hw-myry/esp32s3-4G-watch/04.fotos/solder1.jpg

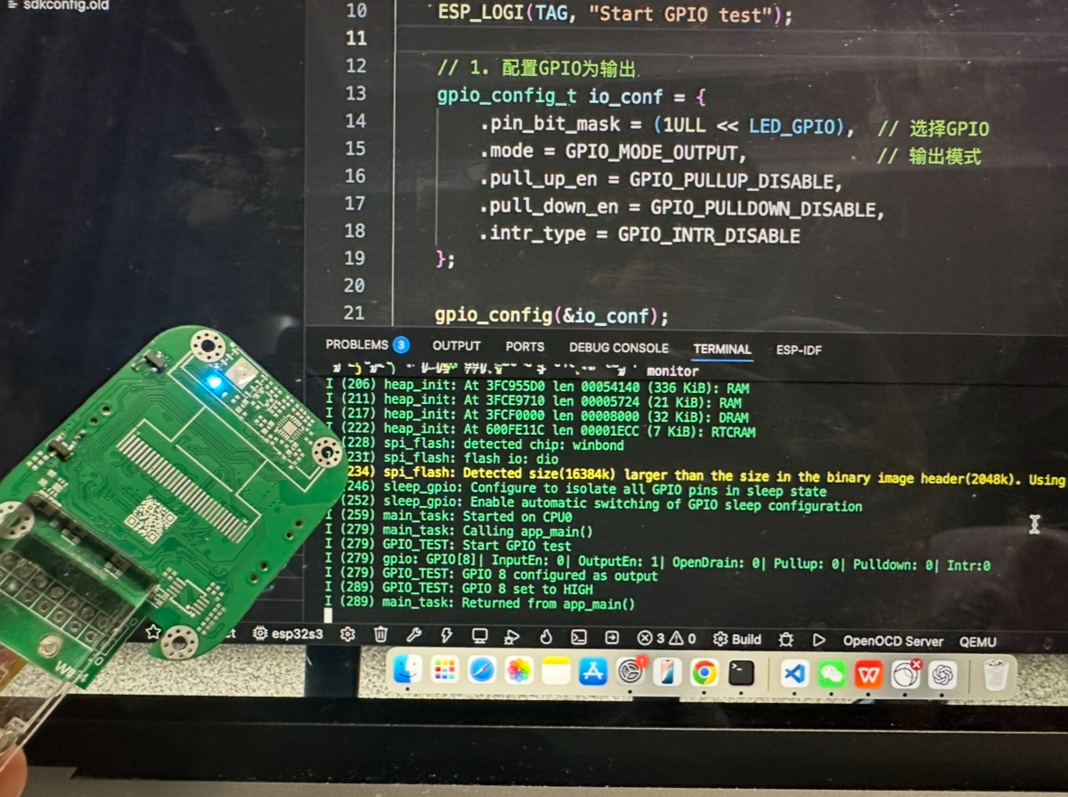
04.fotos/solder1.jpg
