hw-myry/esp32s3-4G-watch/04.fotos/solder2.jpg

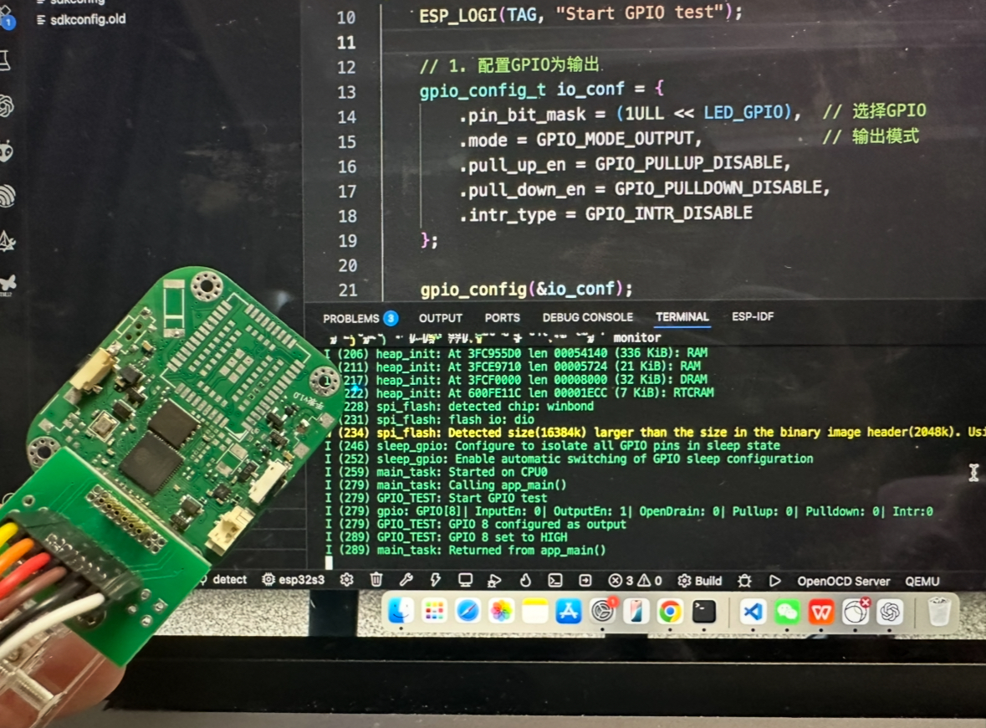
04.fotos/solder2.jpg
