hw-myry/esp32s3-4G-watch/01.hardware/4G-watch.pdf

# SGM6036

# PWR EN

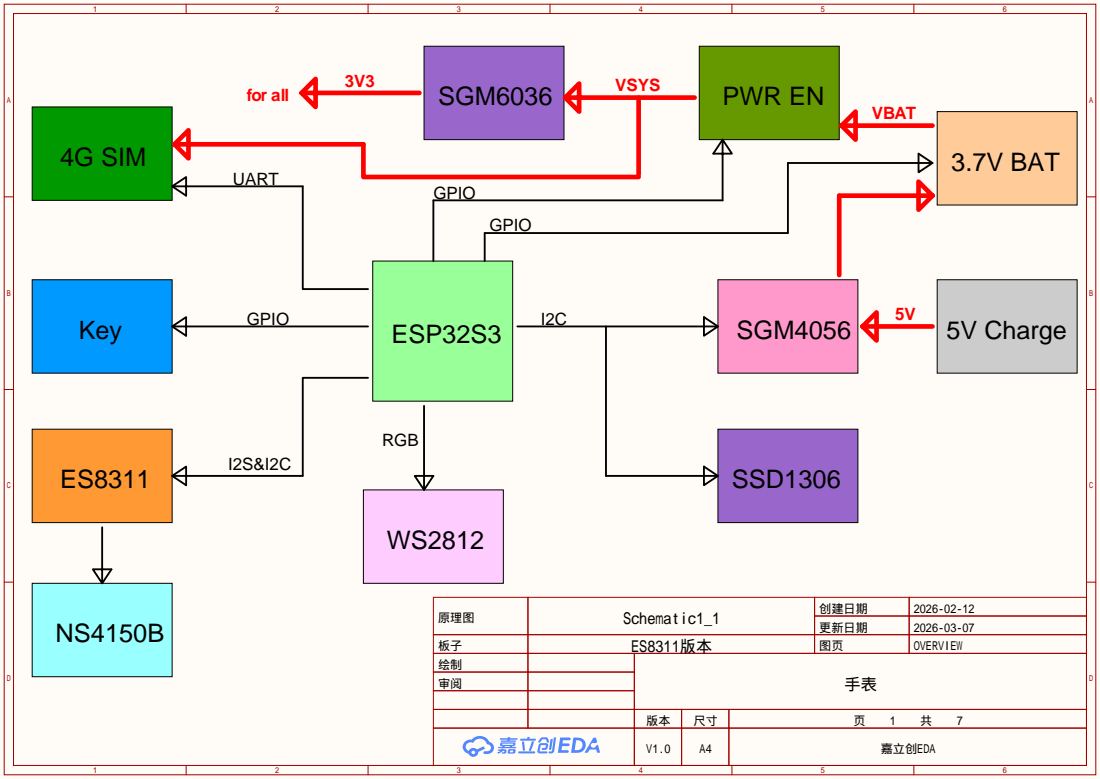
[picture p8: page 1]

原理图 | Schematic1_1 | 创建日期 | 2026-02-12

更新日期 | 2026-03-07

板子 | ES8311版本 | 图页 | OVERVIEW
绘制 | | 手表
审阅

V1.0 | A4 | 嘉立创EDA

# Key

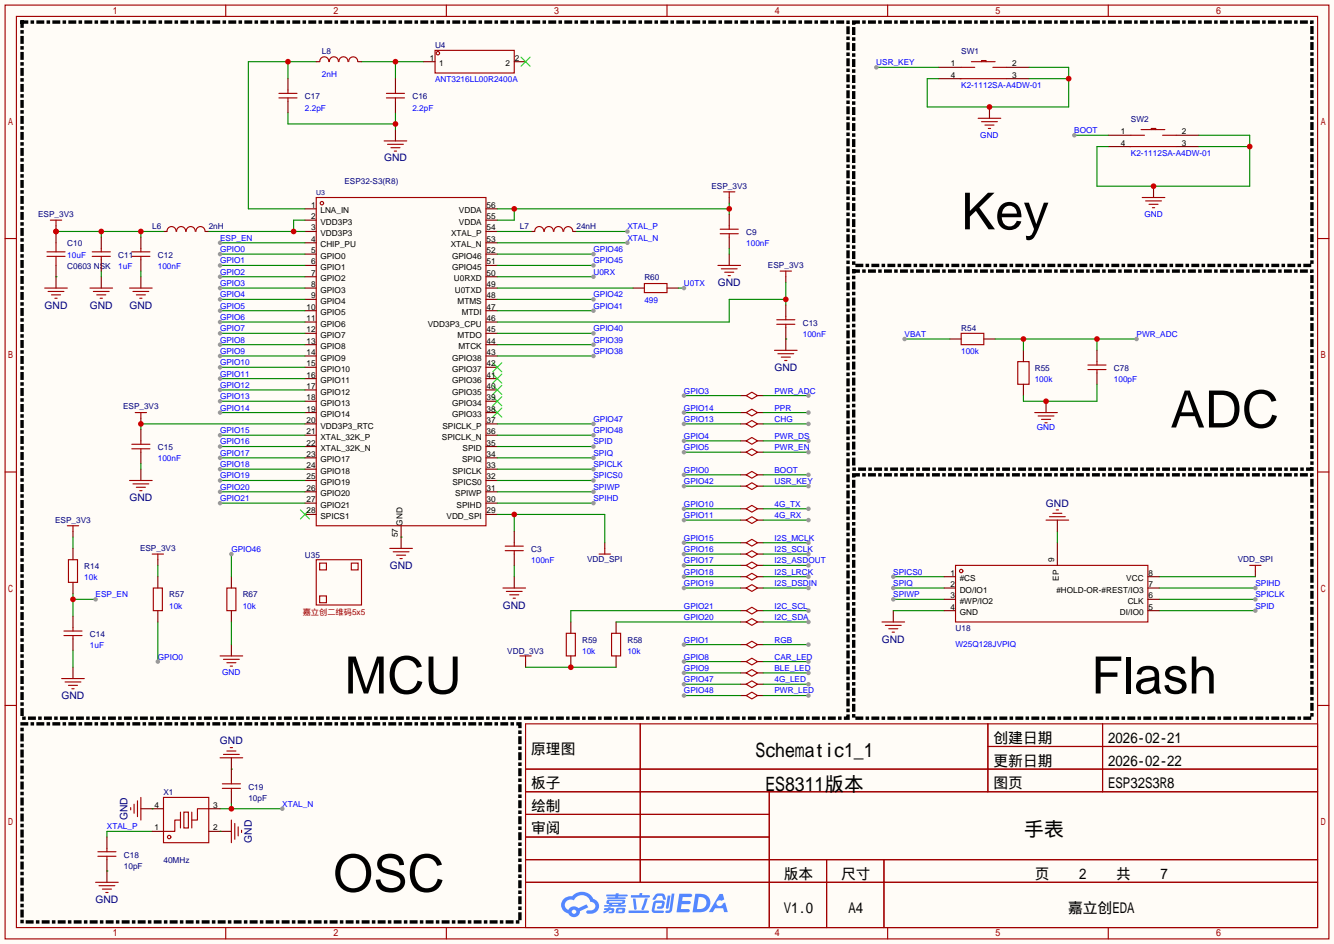
[picture p9: page 2]

原理图 | Schematic1_1 | 创建日期 | 2026-02-21

更新日期 | 2026-02-22

板子 | ES8311版本 | 图页 | ESP32S3R8
绘制 | | 手表
审阅

# SGM6036-3.3YUDT6G/TR GND

# VBAT

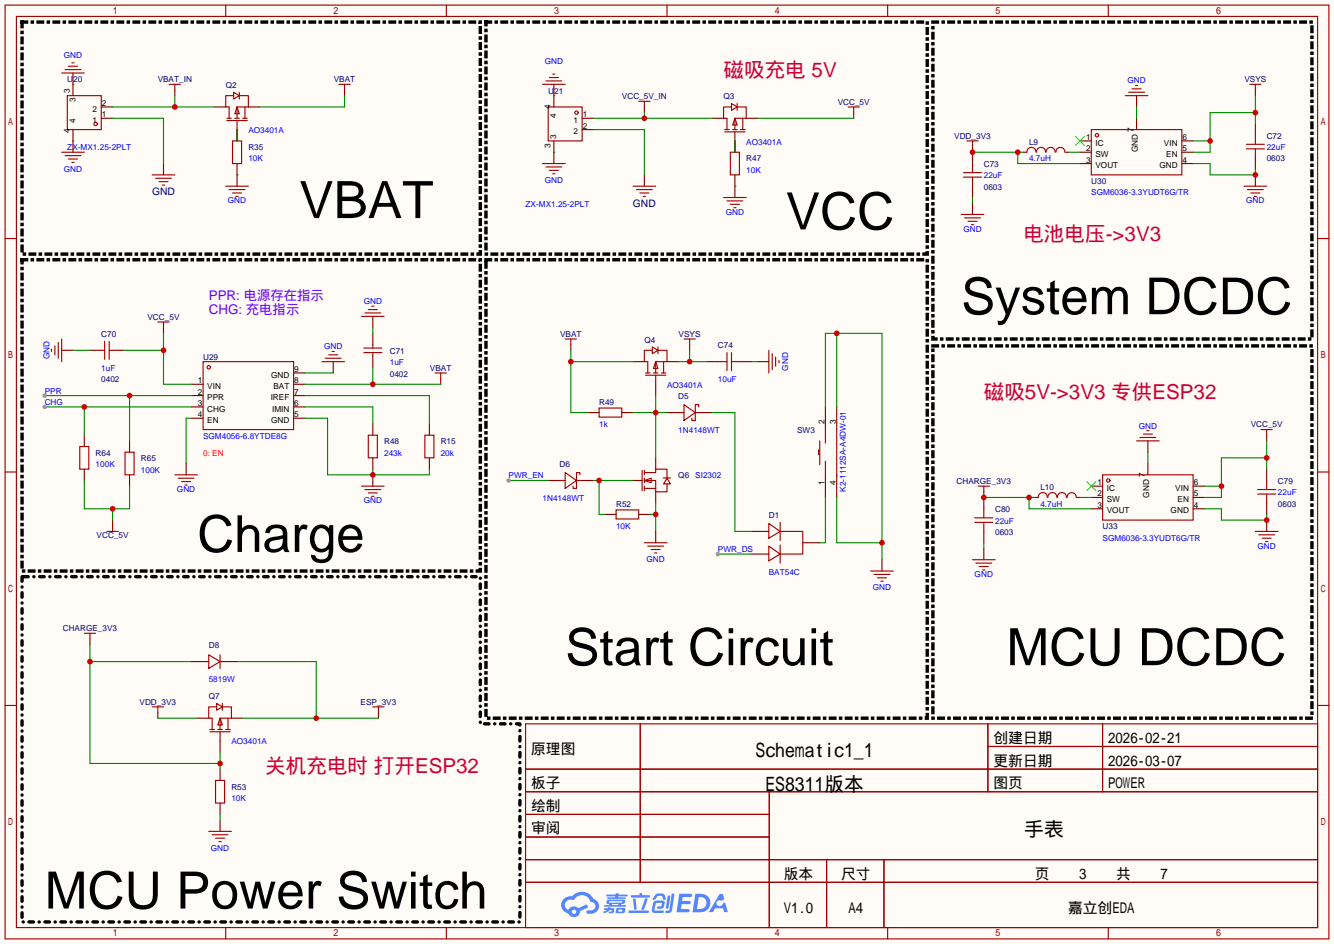
[picture p10: page 3]

原理图 | Schematic1_1 | 创建日期 | 2026-02-21

更新日期 | 2026-03-07

板子 | ES8311版本 | 图页 | POWER
绘制 | | 手表
审阅

GND 47 GND 48 WAKEUP_OUT 49 RSV 50 RSV 51 RSV 52 RSV 53 RSV 54 RSV 55 RSV 56 RSV 57 RSV 58 USB_DP 59 USB_DM 60 USB_VBUS 61 SIM1_CLK 62 SIM1_RST 63 SIM1_DATA 64 SIM1_VCC 65 RSV 66 RSV 67 RSV 68 RSV 69 GND 70 GND 71 GND 72 GND 73 PWM0 74 PWM1 75 GPIO0 76 GPIO1 77 RSV 78 SIM0_DET 79 RSV 80 RSV 81 BOOT_MODE 82 RSV 83 RSV 84 RSV 85 GPIO2 86 GPIO3 87 GND 88 GND 89 GND 90 GND 91 GND 92 GND 93 GND 94

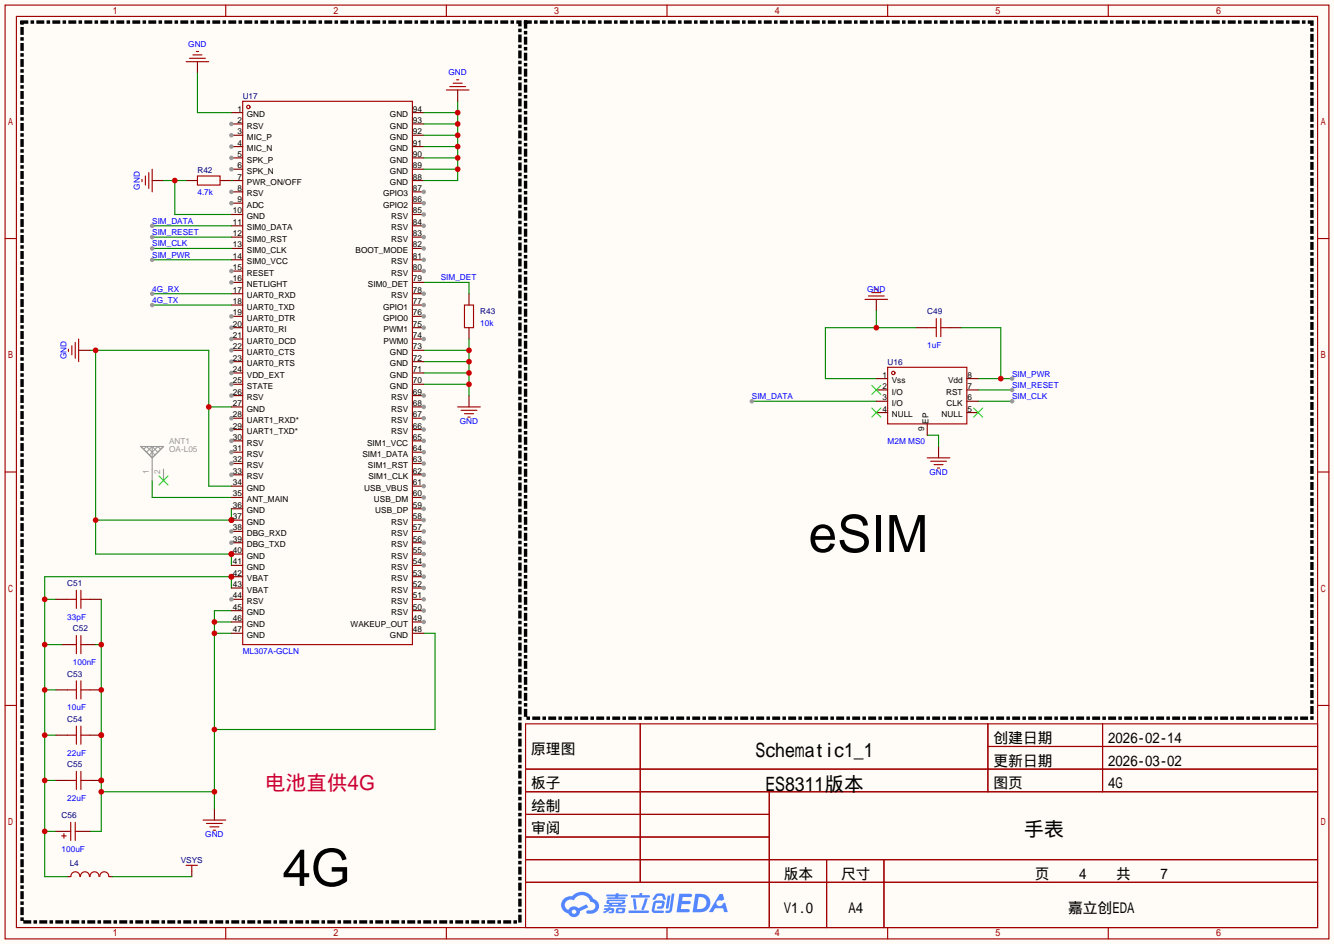
[picture p11: page 4]

原理图 | Schematic1_1 | 创建日期 | 2026-02-14

更新日期 | 2026-03-02

板子 | ES8311版本 | 图页 | 4G
绘制 | | 手表
审阅

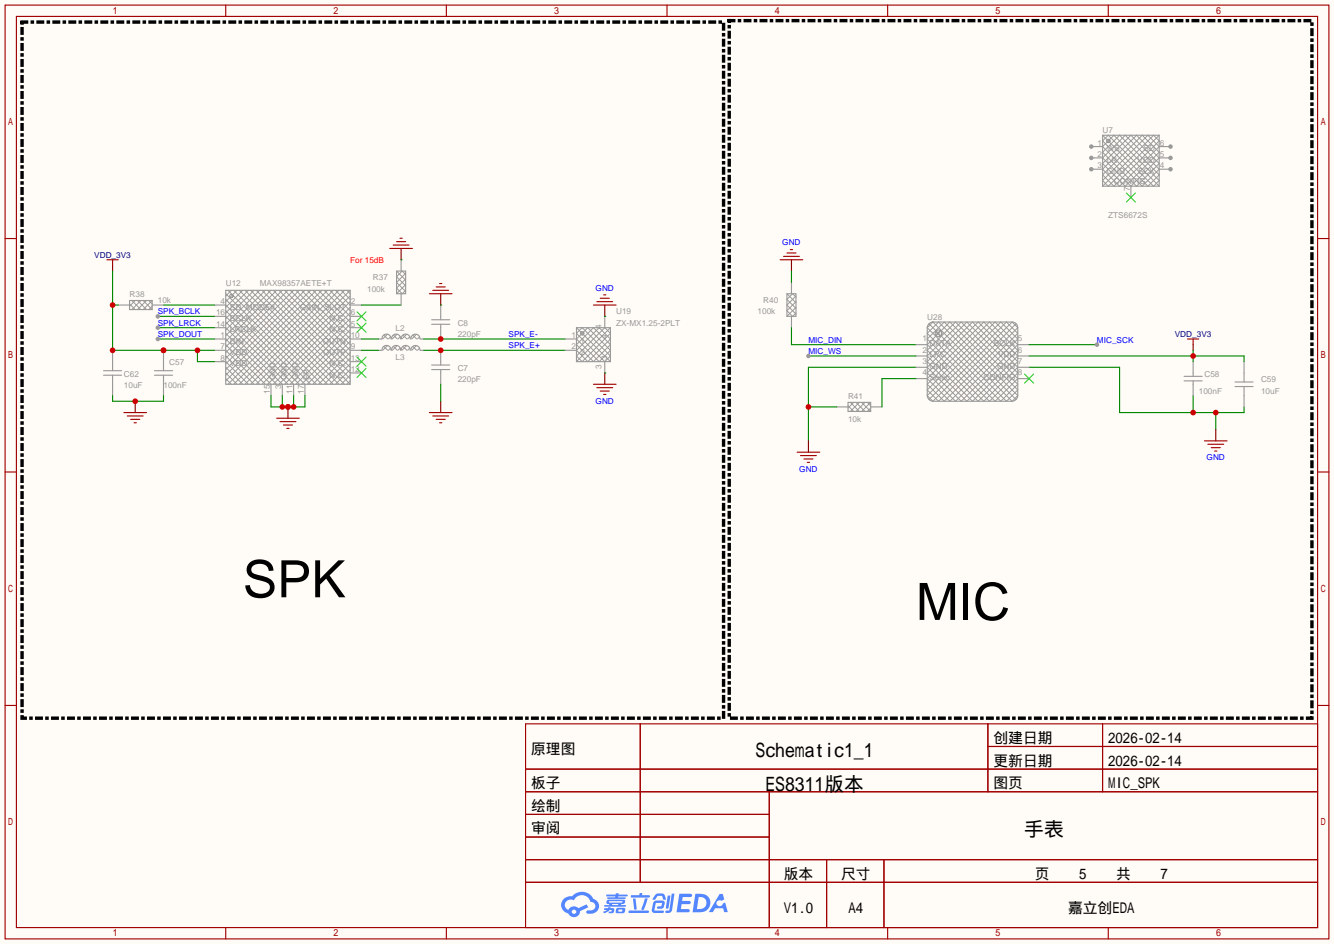
[picture p12: page 5]

原理图 | Schematic1_1 | 创建日期 | 2026-02-14

更新日期 | 2026-02-14

板子 | ES8311版本 | 图页 | MIC_SPK
绘制 | | 手表
审阅

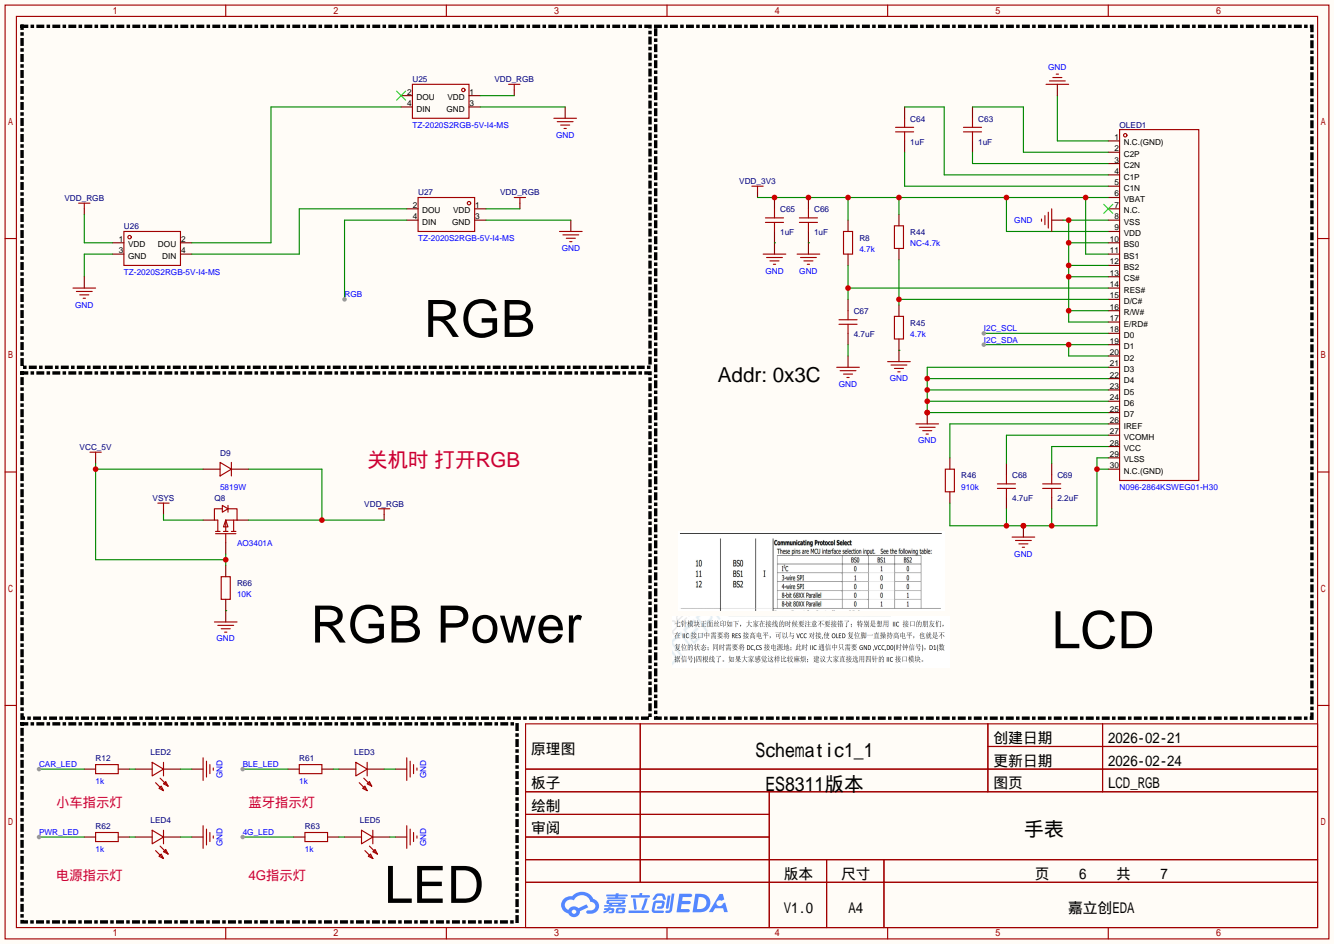
[picture p13: page 6]

原理图 | Schematic1_1 | 创建日期 | 2026-02-21

更新日期 | 2026-02-24

板子 | ES8311版本 | 图页 | LCD_RGB
绘制 | | 手表
审阅

# Addr: 0x18

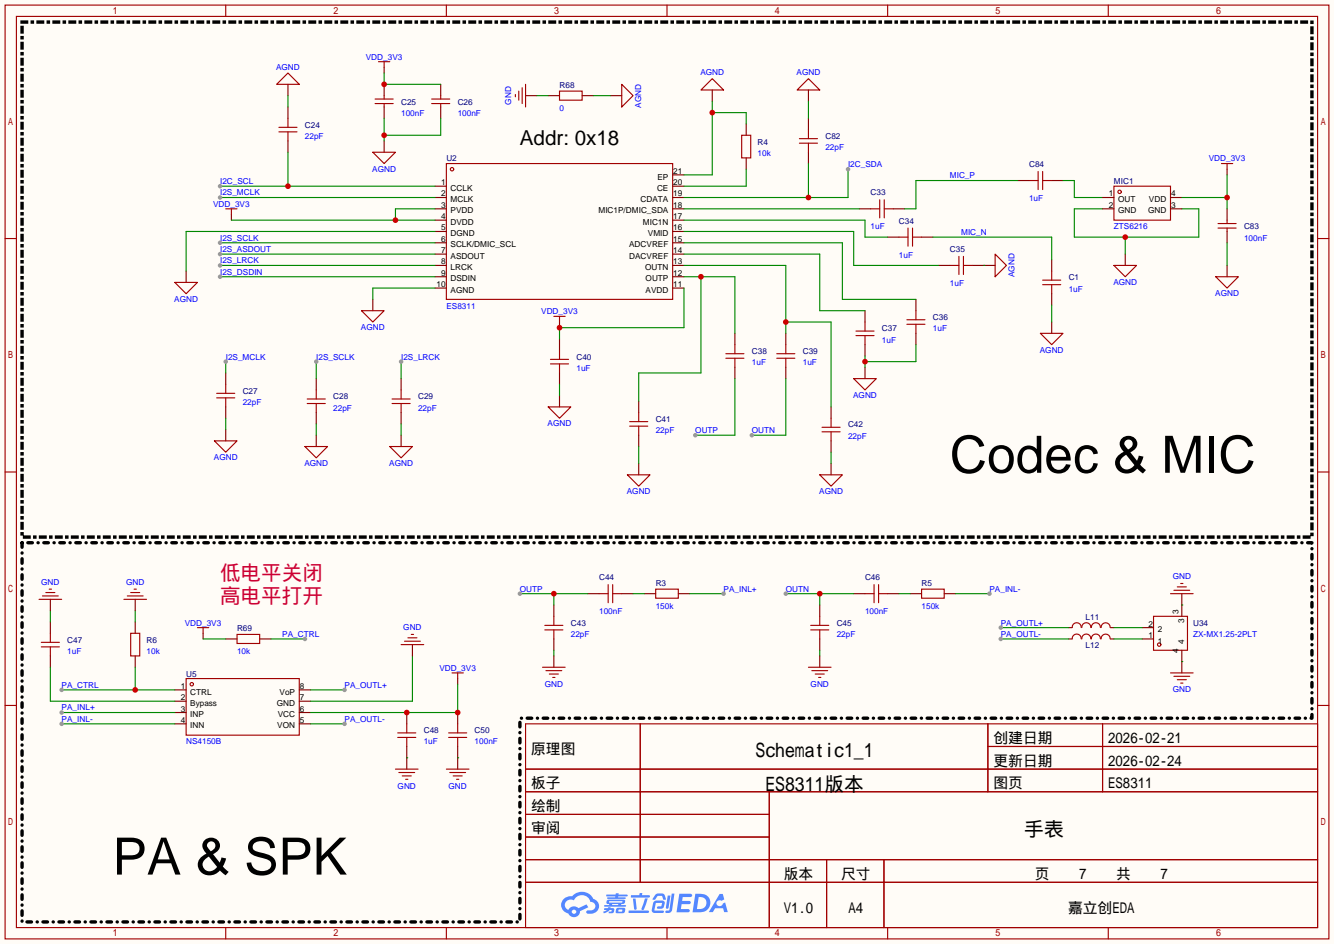
[picture p14: page 7]

原理图 | Schematic1_1 | 创建日期 | 2026-02-21

更新日期 | 2026-02-24

板子 | ES8311版本 | 图页 | ES8311
绘制 | | 手表
审阅
