hw-myry/esp32s3-4G-watch/(list of files, drawings)

Other design files:
01.hardware/4G-watch-pcb.epro
