hw-myry/esp32s3-4G-watch/(commit log)

2026-03-15 add blink code
    [4G-watch-pcb.epro]
2026-03-15 add gerber and pdf
2026-03-16 power test
2026-03-16 add charge_ic doc
2026-03-20 verify rgb adc
